linuxluigi/kellerbot/README.rst

.. These are the Travis-CI and Coveralls badges for your repository. Replace
    your *github_repository* and uncomment these lines by removing the leading two dots.

.. 

.. 

.. 

- Online Dokumentation: https://kellerbot.readthedocs.io/de/latest/
- Quellcode: https://github.com/linuxluigi/kellerbot
- Präsentation: https://github.com/linuxluigi/kellerbot/raw/master/docs/_static/pr%C3%A4sentation.odp

``kellerBot`` ist ein Raspberry Pi & Arduino Projekt, welches anhand eines 2 ardigen Kabels misst, ob Wasser an den
Kabelenden ist, das Kabel kurzgeschlossen, das Kabel nicht angeschlossen oder ob das Kabel ohne geschlossenden
Stromkreis angeschlossen ist. Diese Daten werden von einem Telegram_ Bot in einer Chat Gruppe angezeigt.

Die :numref:`project-logo` ist das Projekt Logo, welches als Avatar für den Telegram Bot verwendet wird.

.. _Telegram: https://telegram.org/

.. _project-logo:
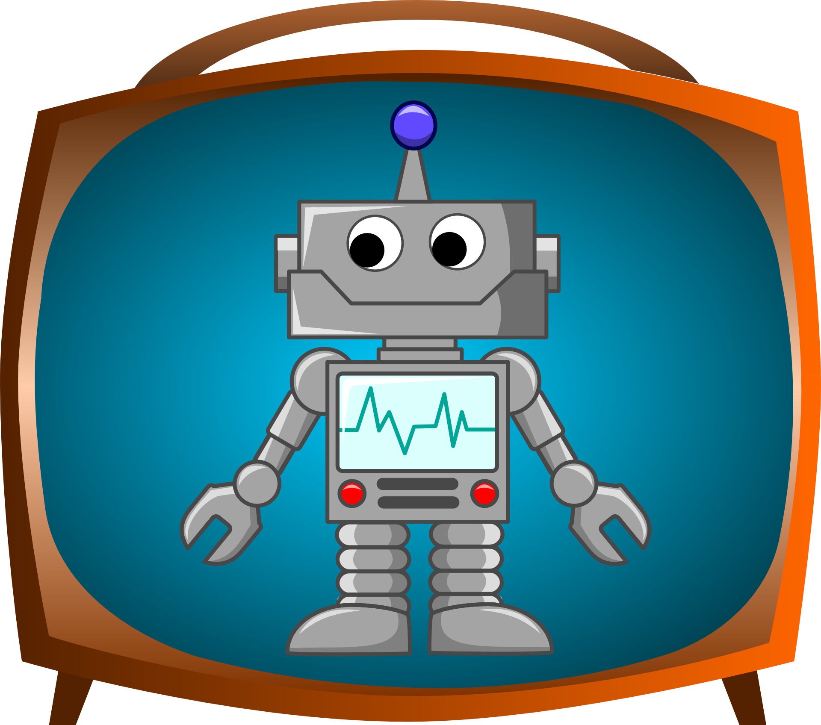
[picture p1: docs/_static/android-161184.png]
Projekt Logo


    Projekt Logo, Quelle: https://pixabay.com/en/android-bot-robot-television-happy-161184/

**Hardware**

Im der :numref:`projekt-aufbau` ist der komplette Aufbau zu sehen.

* Raspberry Pi Modell B+ V1.2
* DHT22 Temperatur- & Luftfeuchtigkeitssensor
* mehrere Arduinos Nanos + jeweils 2 ardige Kupferkabel
* USB WLAN Stick oder :term:`WLAN zu LAN Bridge`

.. _projekt-aufbau:
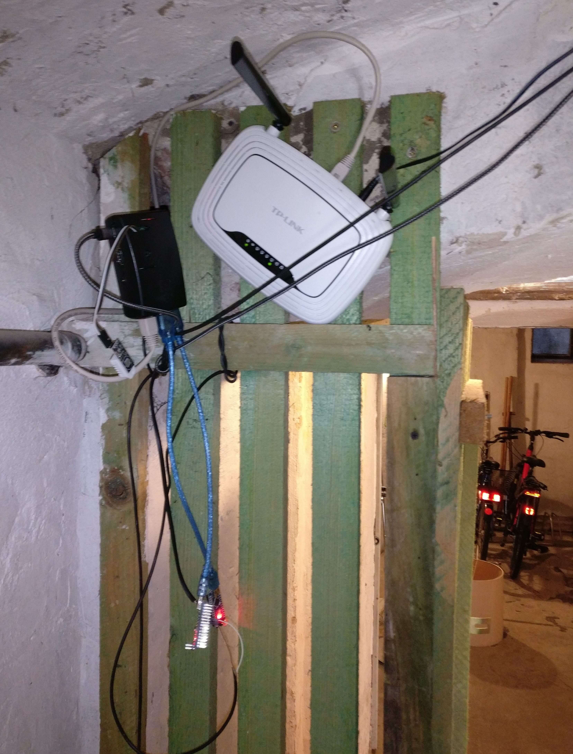
[picture p2: docs/_static/fotos/IMG_20190110_132612.jpg]
Projekt Aufbau


    Projekt Aufbau

**Telegram Bot Befehle**::

    hilfe - zeige alle Befehle an
    temperatur - Temperatur anzeigen
    luftfeuchtigkeit - Luftfeuchtigkeit anzeigen
    wassermelder - Wassertest
