linuxluigi/kellerbot/docs/glossar.rst

Glossar
=======

.. glossary::
    :sorted:

    GPIO
        Abkürzung für `General Purpose Input Output`, dies bezeichnet programmierbare Ein- und Ausgänge für allgemeine Zwecke

    Raspberry Pi
        Ein Open Source Hard- & Software Minicomputer, der mit dem Ziel entwickelt wurde, nicht über 35$ zu kosten und
        sich durch geringen Stromverbrauch & durch Open Source Betriebsysteme für viele IT Projekte bewährt und
        beliebt gemacht hat.

    Arduino
        Ein Open Source Hard- & Software Gerät mit einem einfachen Eingabe und Ausgabe Board, einem
        Mikrocontroller sowie analogen und digitalen Ein- und Ausgängen. Arduino soll eine einfache PLattform für
        Entwickler Einsteiger sein, die mit dieser Plattform programmieren und den Umgang mit Hardware lernen können.

    Arduino Nanos
    Arduino Nano
        Ist eine kompakte Version eines Arduinos.

    DHT22 Temperatur- und Luftfeuchtigkeitssensor
        Der DHT22 ist ein Sensor zum Auslesen von Temperatur & Luftfeuchtigkeit, welcher leicht von einen Arduino,
        Raspberry Pi oder ähnlichen Geräten verwendet werden kann.

    Einplatinenrechner
        Auf einer Leiterplatte befinden sich alle nötigen elektronischen Komponenten zum Betreiben eines Computersystems.

    WLAN Access Point
    Access Point
        Basisstation zur kabellosen Kommunikation im LAN.

    openWrt
        Open Source Router Betriebsystem, welches meist mehr Funktionen bietet als die Betriebsysteme der Hardware Hersteller
        besitzen. OpenWart wird aktiv von Freifunkern verwendet um ein freies offenes Internet
        für alle anbieten zu können.

    WLAN zu LAN Bridge
        Ein WLAN Router, welcher sich in ein exitierendes WLAN Netzwerk einwählt und dies als Internet Quelle dem LAN freigibt.

    Token
        Ein Schlüssel zur Authefizierung einer Schnittstelle.

    Powerline
        Ethernet über die Steckdose.
