linuxluigi/kellerbot/docs/warning.rst

.. warning::
    **Beta Software:**

    Diese Software hat noch nicht die stable Version erreicht. Es kann sein, dass sich
    die Struktur, Interface oder API ändern oder andere große Änderungen
    passieren, bevor die Version *1.0* erreicht wird.
