linuxluigi/kellerbot/docs/_static/präsentation.odp

## KellerBot

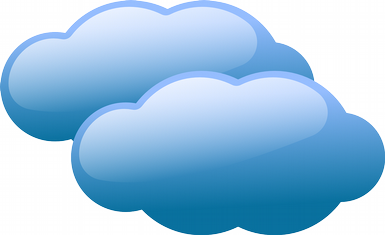
[picture p12: figure]
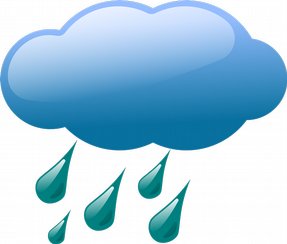
[picture p13: figure]

Wasserwarnmeldesystem

1

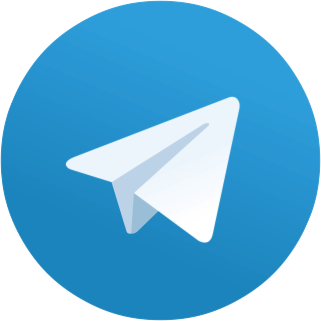
[picture p14: figure]
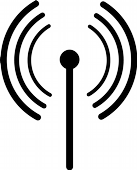
[picture p15: figure]
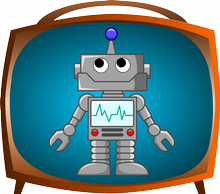
[picture p16: figure]
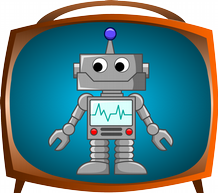
[picture p17: figure]

## Zu lösendes Problem

- 2 Wasserschäden im Keller seid dem ich im Haus Wohne (ca. 3 Jahre)
- Letzter großer Schaden zur Ferienzeit und es hätte fast keiner für mehrere tage bemerkt

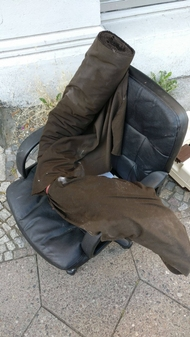
[picture p18: figure]
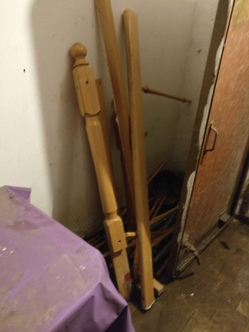
[picture p19: figure]

## Lösung: Raspberry Pi mit Telegram

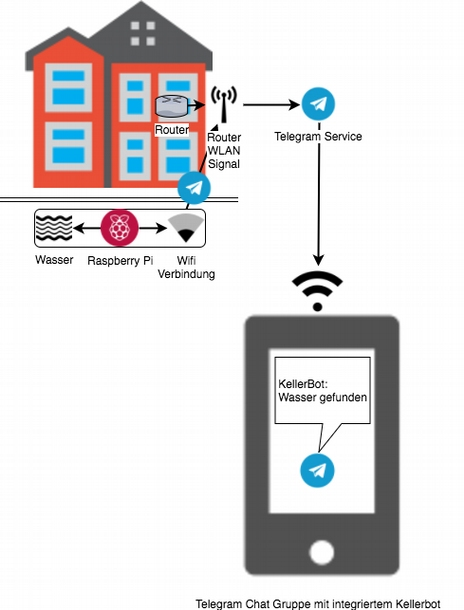
[picture p20: figure]

## Aufbau 1

- Limitierte Anzahl von Sensoren
- Geringe Abtastrate von 3 Minuten
- Kein unterschied zwischen Fehlerfrei und kein Kabel
- Nur 2 Sensor Zustände

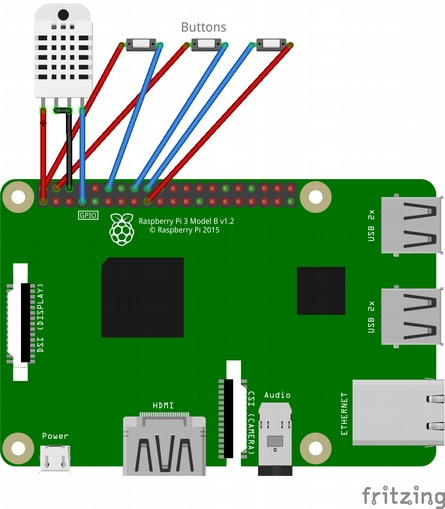
[picture p21: figure]

## Aufbau 2

- Sehr hohe Anzahl von Sensoren möglich
- Echtzeit Erkennung
- 4 Kabelzustände
- Benötigt mehr Hardware als Aufbau 1

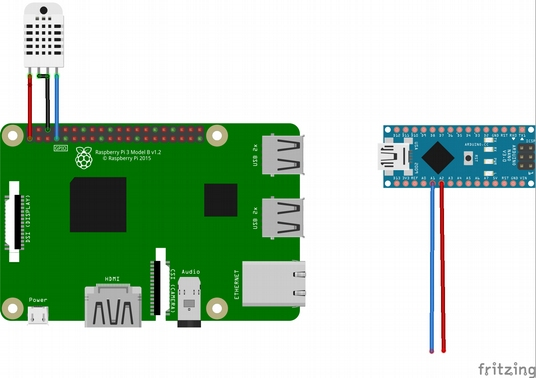
[picture p22: figure]

## Kapazitätsmessung

- Bei der Kapazitätsmessung wird geprüft, wie lange die Kapazität C benötigt um 63.2% ihrer gesamten Spannung zu laden. Dabei wird die Zeitkonstante TC über einen Widerstandskondensator RC innerhalb des Stromkreislaufs gemessen.
- Formel C = TC / R
  - C = Kapazität in Fahrad
  - R = Widerstand in Ohm
  - TC = Zeitkonstante in Sekunden
- Zustände:
  - Kurzgeschlossen inf nf
  - Kleiner 0.001 nf kein Kabel angeschlossen
  - Kleiner gleich 30.000 nf Kabel angeschlossen
  - Sonst Wasser

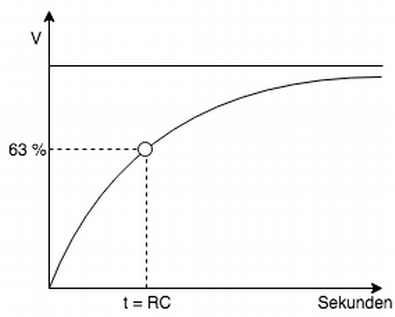
[picture p23: figure]

## Aufbau 2 im Keller

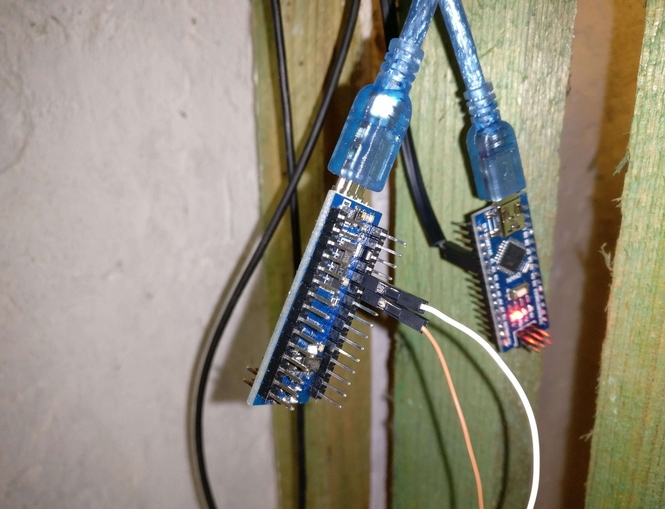
[picture p24: figure]
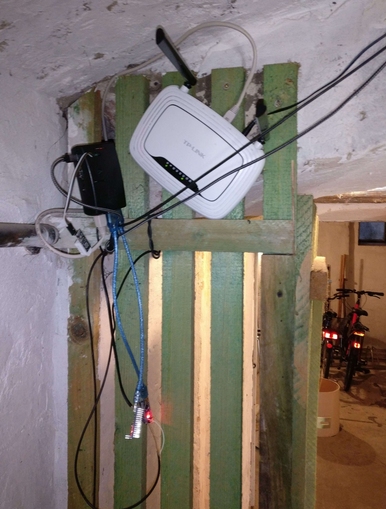
[picture p25: figure]

## Aufbau 2: Sensorkabel

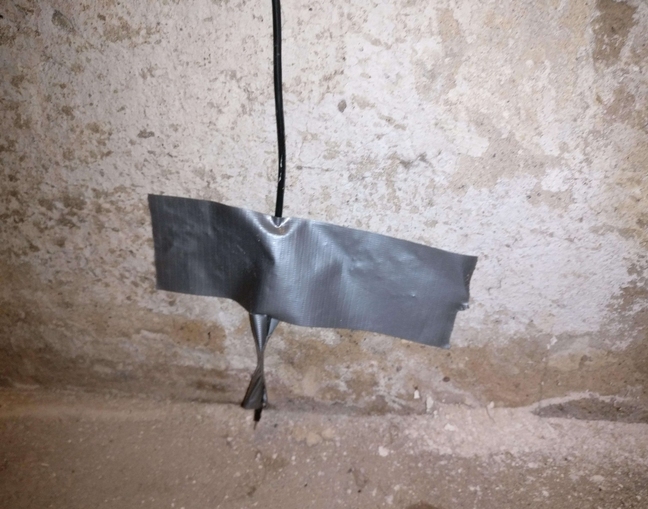
[picture p26: figure]
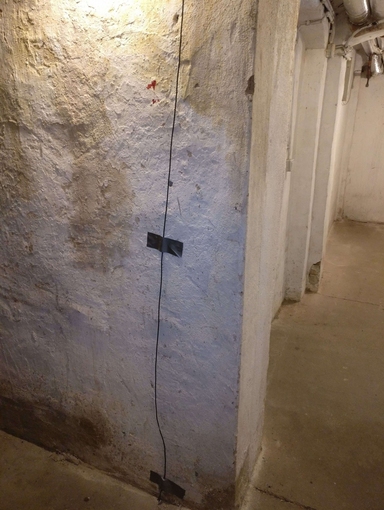
[picture p27: figure]

## Aufbau 2: Stromverbauchmessung

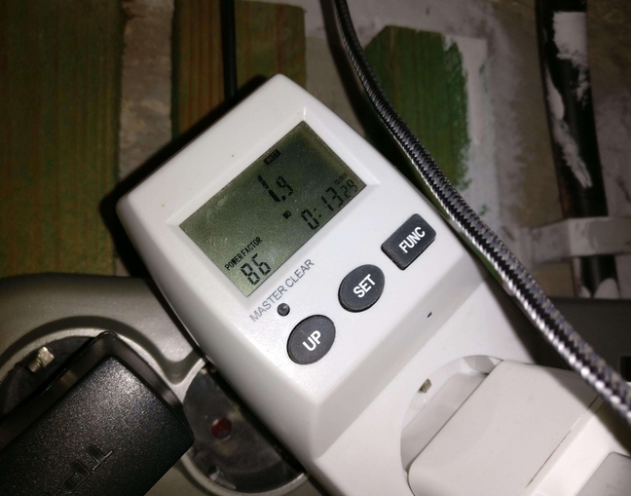
[picture p28: figure]

## Fazit

- Vorhandenes Problem wurde kosteneffektiv gelöst
- Telegram Bots zu schreiben ist sehr einfach
- Der nächste Wasserschaden kann kommen ;)
  Projekt URL: https://github.com/linuxluigi/kellerbot

1
