linuxluigi/kellerbot/docs/_static/fotos/IMG_20190110_132604.jpg

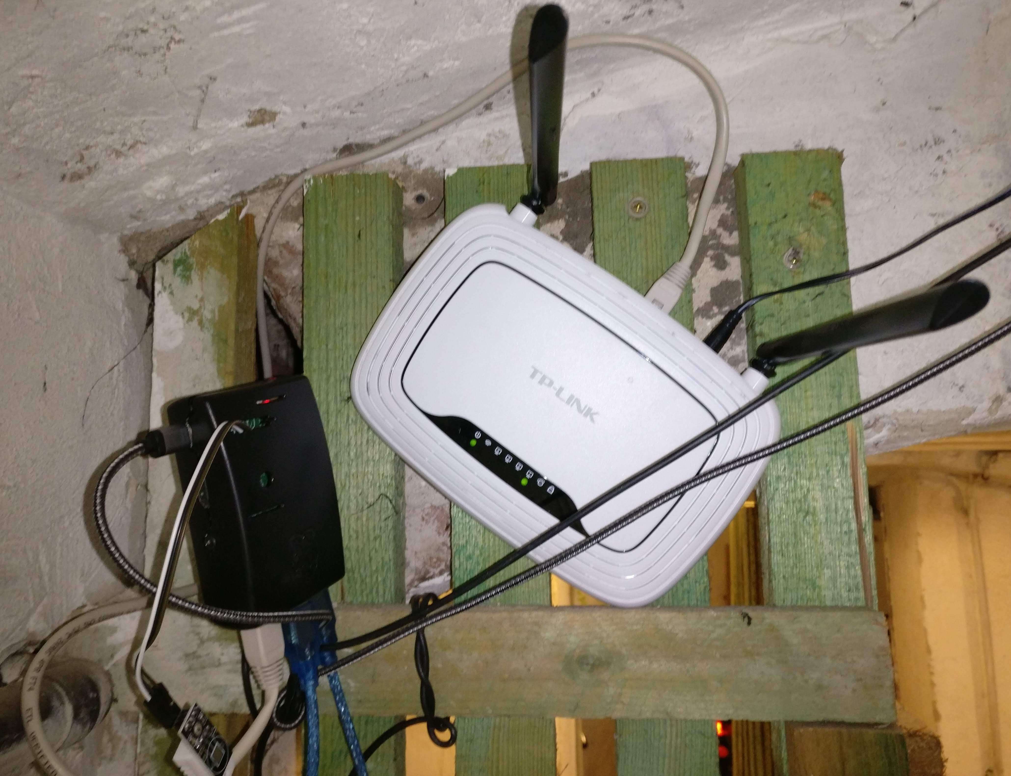
docs/_static/fotos/IMG_20190110_132604.jpg
