linuxluigi/kellerbot/docs/_static/fotos/IMG_20190110_132741.jpg

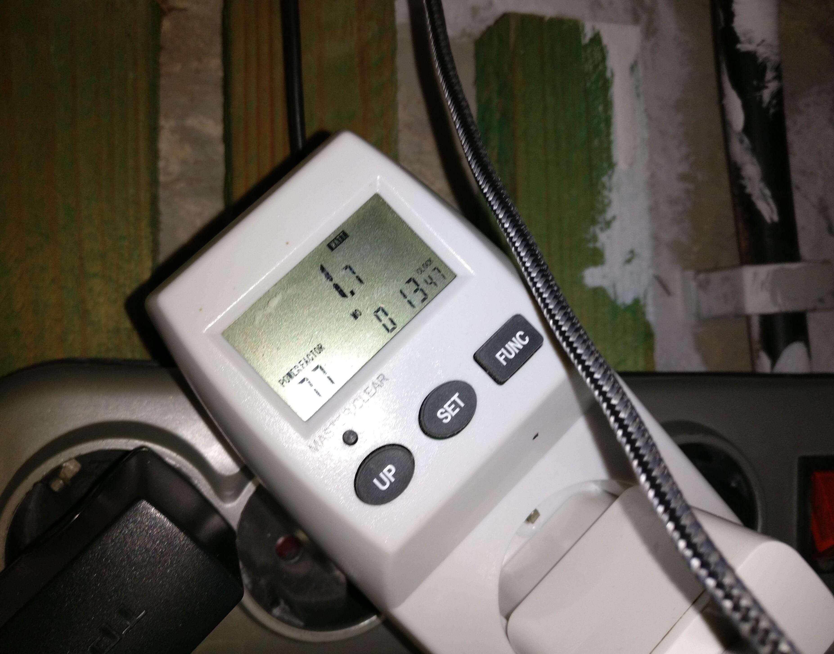
docs/_static/fotos/IMG_20190110_132741.jpg
