linuxluigi/kellerbot/docs/_static/fotos/IMG_20190110_132936.jpg

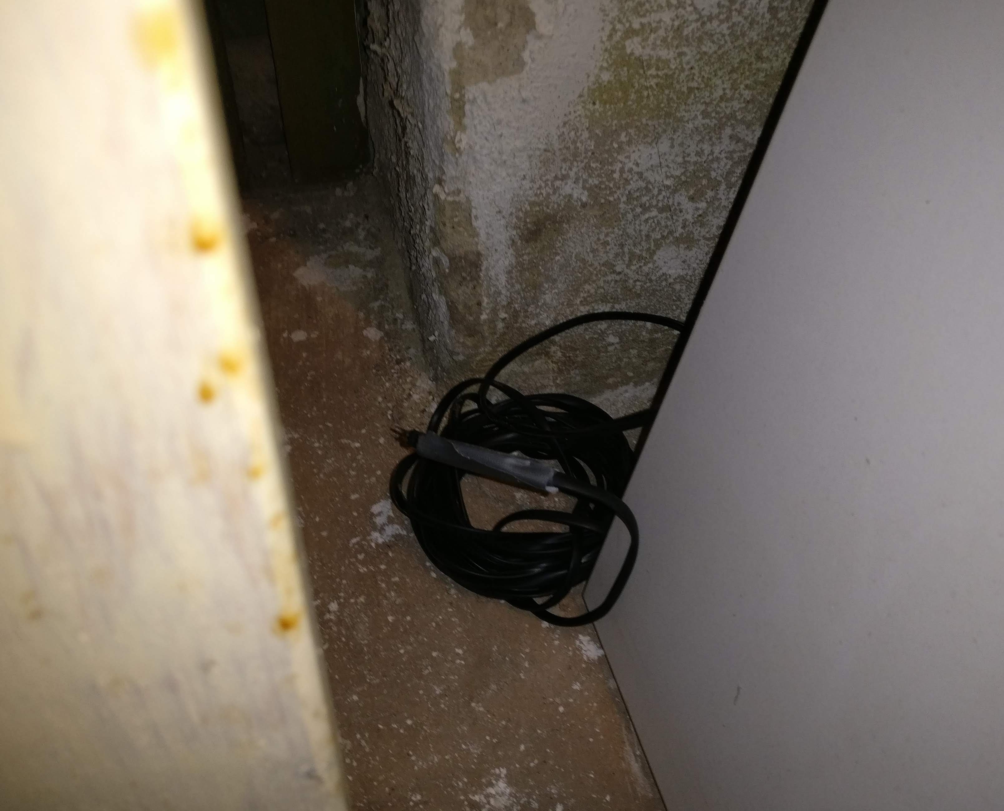
docs/_static/fotos/IMG_20190110_132936.jpg
