linuxluigi/kellerbot/docs/_static/presentation/rain.png

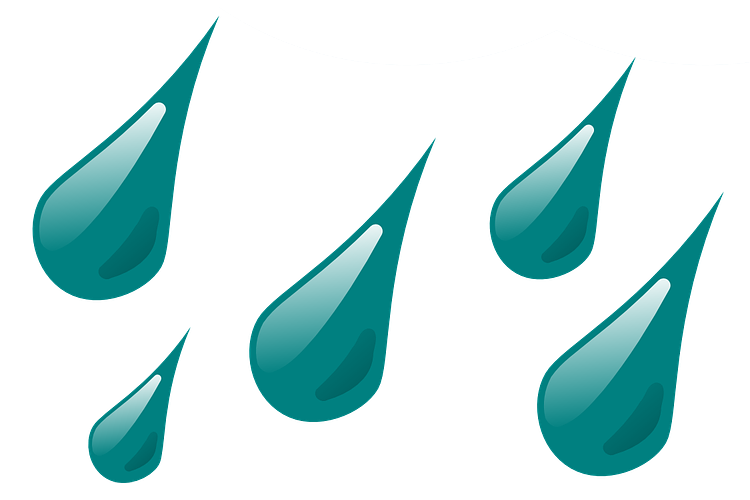
docs/_static/presentation/rain.png
