linuxluigi/kellerbot/(list of files, drawings)

Other design files:
docs/_static/Arduino.fzz
docs/_static/TelegramBot.fzz
docs/_static/TelegramBot_raspberry_pi_version.fzz
