linuxluigi/kellerbot/arduino-capacitance-meter/arduino-capacitance-meter.ino

// tutorial http://www.circuitbasics.com/how-to-make-an-arduino-capacitance-meter/

const int OUT_PIN = A2;
const int IN_PIN = A1;
const float IN_STRAY_CAP_TO_GND = 24.48;
const float IN_CAP_TO_GND  = IN_STRAY_CAP_TO_GND;
const float R_PULLUP = 34.8;  
const int MAX_ADC_VALUE = 1023;

void setup()
{
  pinMode(OUT_PIN, OUTPUT);
  pinMode(IN_PIN, OUTPUT);
  Serial.begin(9600);
}

void loop()
{
    // farads
    // uF -> microfarads = 1000000uf -> 1 F
    // nF -> nanofarads = 1000 -> 1uF
    // pF -> micromicrofarads or picofarads = 1000 -> 1 nF
  
    pinMode(IN_PIN, INPUT);
    digitalWrite(OUT_PIN, HIGH);
    int val = analogRead(IN_PIN);
    digitalWrite(OUT_PIN, LOW);

    if (val < 1000)
    {
      pinMode(IN_PIN, OUTPUT);

      float capacitance = (float)val * IN_CAP_TO_GND / (float)(MAX_ADC_VALUE - val);

      Serial.println(capacitance / 1000.0, 10);
    }
    else
    {
      pinMode(IN_PIN, OUTPUT);
      delay(1);
      pinMode(OUT_PIN, INPUT_PULLUP);
      unsigned long u1 = micros();
      unsigned long t;
      int digVal;

      do
      {
        digVal = digitalRead(OUT_PIN);
        unsigned long u2 = micros();
        t = u2 > u1 ? u2 - u1 : u1 - u2;
      } while ((digVal < 1) && (t < 400000L));

      pinMode(OUT_PIN, INPUT);  
      val = analogRead(OUT_PIN);
      digitalWrite(IN_PIN, HIGH);
      int dischargeTime = (int)(t / 1000L) * 5;
      delay(dischargeTime);   
      pinMode(OUT_PIN, OUTPUT);  
      digitalWrite(OUT_PIN, LOW);
      digitalWrite(IN_PIN, LOW);

      float capacitance = -(float)t / R_PULLUP
                              / log(1.0 - (float)val / (float)MAX_ADC_VALUE);
      
      Serial.println(capacitance, 10);
      
    }
    while (millis() % 1000 != 0)
      ;    
}
