linuxluigi/kellerbot/(commit log)

2018-10-14 change GPIO Pins & add doc
    [TelegramBot.fzz]
2019-01-03 add arduino as sensor instead of 2 wires from the raspberry pi
    [TelegramBot.fzz]
2019-01-04 change project fritzing image from svg to png
    [TelegramBot.fzz]
2019-01-04 change documentation link url from en to de
2019-01-15 update docs
    [Arduino.fzz, TelegramBot.fzz, TelegramBot_raspberry_pi_version.fzz]
